diygary/FlightSimInstrumentPanel/README.md

Please visit https://www.diygary.com/instrumentpanel for more info.

NOTE: Not all dials/switches on the PCB are functional due to limitations with the SimConnect display (lack of writeable Simulation Variables)
