diygary/FlightSimInstrumentPanel/Schematics and Board Files/README.txt

Schematics and board files not shown here.
Contact Gary T Smith (aka DIYGary) for more info.
