diygary/FlightSimInstrumentPanel/schematic.brd

## EAGLE design schematic.brd (2021-06-20, last stored version)

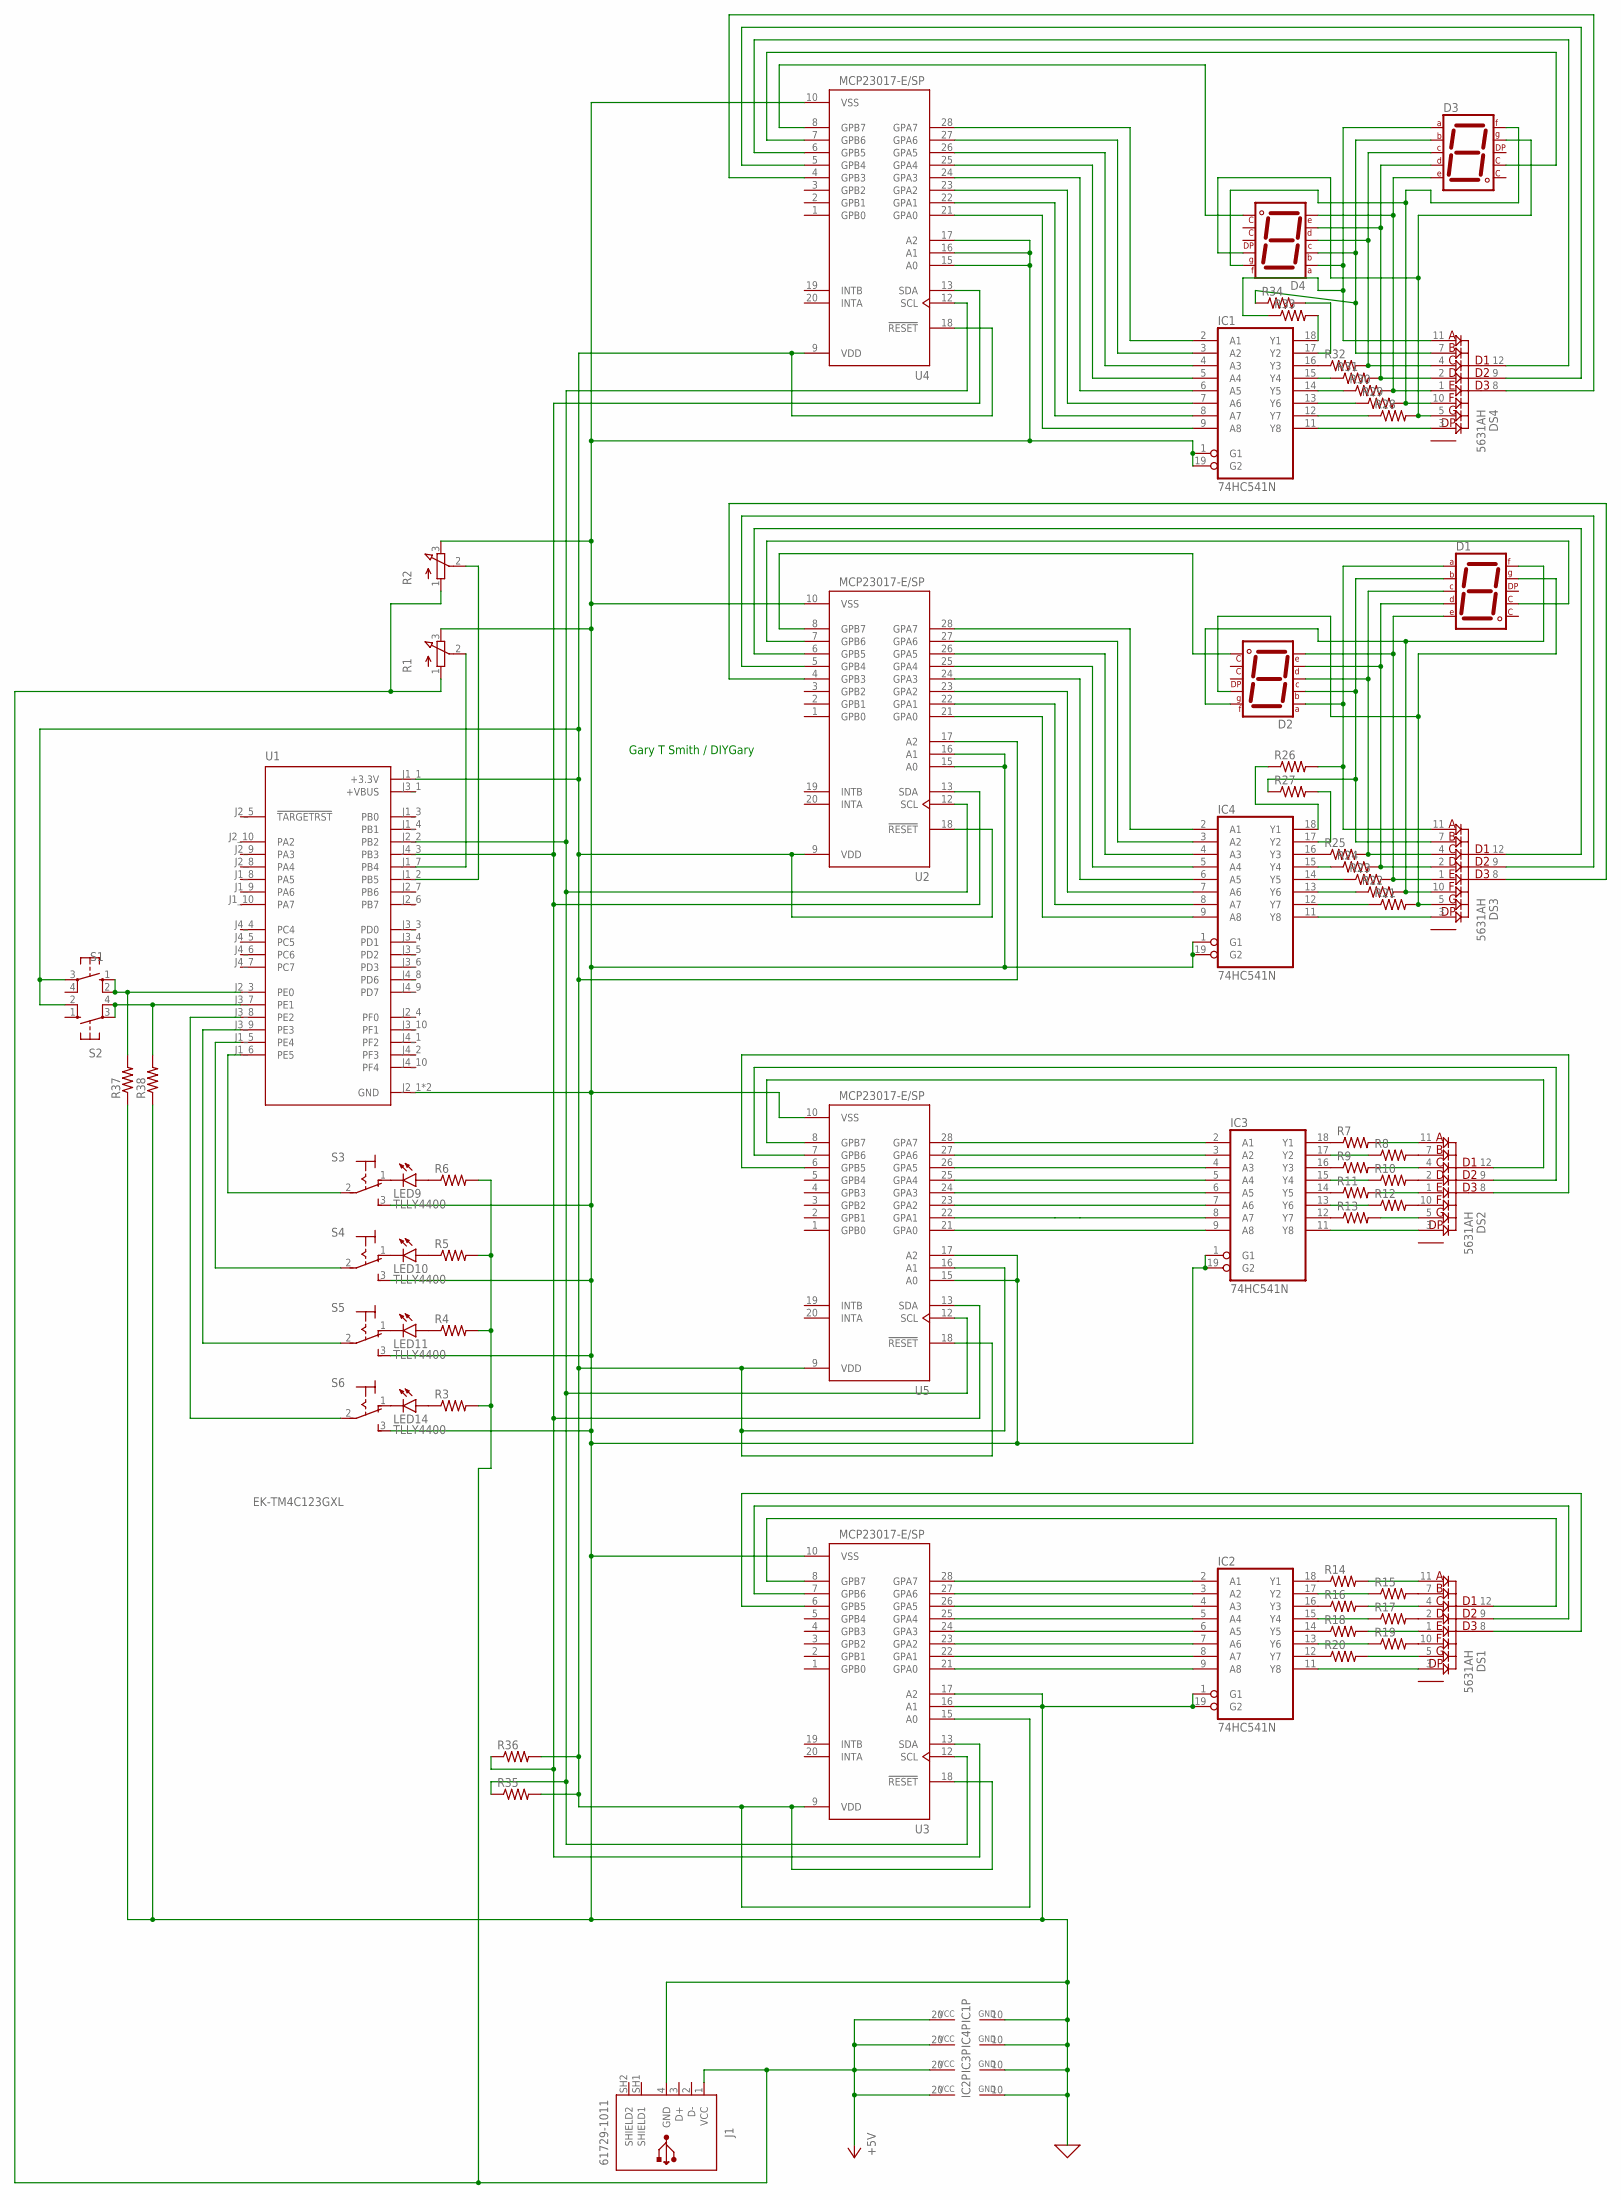
[picture p3: schematic schematic.sch]

Parts:
D1, D2, D3, D4: 5611AH
DS1, DS2, DS3, DS4: 5631AH; DIPS1524W50P254L3760H835Q12N
IC1, IC2, IC3, IC4: 74HC541N; DIL20
J1: 61729-1011; 61729-1011BLF
LED9, LED10, LED11, LED14: TLLY4400; LED3MM
R1, R2: 3RP/1610N
R3, R4, R5, R6, R7, R8, R9, R10, R11, R12, R13, R14, R15, R16, R17, R18, R19, R20, R21, R22, R23, R24, R25, R26, R27, R28, R29, R30, R31, R32, R33, R34, R35, R36, R37, R38: R-US_0204/7; 0204/7
S1, S2: 10-XX; B3F-10XX
S3, S4, S5, S6: 320-916
U1: EK-TM4C123GXL; MODULE_EK-TM4C123GXL
U2, U3, U4, U5: MCP23017-E/SP; DIP787W45P254L3556H508Q28

Connections:
0: IC1.1 (G1), IC1.10 (GND), IC1.19 (G2), IC2.1 (G1), IC2.10 (GND), IC2.19 (G2), IC3.1 (G1), IC3.10 (GND), IC3.19 (G2), IC4.1 (G1), IC4.10 (GND), IC4.19 (G2), J1.4 (GND), R1.3 (E), R2.3 (E), R37.1, R38.1, S3.3 (S), S4.3 (S), S5.3 (S), S6.3 (S), U1.J2_1 (GND), U1.J3_2 (GND), U2.10 (VSS), U2.15 (A0), U2.16 (A1), U3.10 (VSS), U3.16 (A1), U3.17 (A2), U4.10 (VSS), U4.15 (A0), U4.16 (A1), U4.17 (A2), U5.10 (VSS), U5.15 (A0), U5.17 (A2)
+VBUS: U1.J3_1 (+VBUS)
unnamed: IC1.9 (A8), U4.21 (GPA0)
unnamed: DS1.7 (A_B), R15.2
unnamed: DS1.2 (A_D), R17.2
unnamed: DS1.10 (A_F), R19.2
unnamed: DS2.7 (A_B), R8.2
unnamed: DS2.2 (A_D), R10.2
unnamed: DS2.10 (A_F), R12.2
unnamed: D3.7 (A), D4.7 (A), DS4.11 (A_A), R33.1
unnamed: IC1.8 (A7), U4.22 (GPA1)
unnamed: IC1.7 (A6), U4.23 (GPA2)
unnamed: IC1.6 (A5), U4.24 (GPA3)
unnamed: IC1.5 (A4), U4.25 (GPA4)
unnamed: IC1.4 (A3), U4.26 (GPA5)
unnamed: IC1.3 (A2), U4.27 (GPA6)
unnamed: IC1.2 (A1), U4.28 (GPA7)
unnamed: D3.3 (CK1), U4.7 (GPB6)
unnamed: DS4.12 (CC_D1), U4.6 (GPB5)
unnamed: DS4.9 (CC_D2), U4.5 (GPB4)
unnamed: DS4.8 (CC_D3), U4.4 (GPB3)
unnamed: D1.7 (A), D2.7 (A), DS3.11 (A_A), R26.2
unnamed: IC1.16 (Y3), R32.1
unnamed: IC1.12 (Y7), R28.1
unnamed: IC1.13 (Y6), R29.1
unnamed: D1.1 (E), D2.1 (E), DS3.1 (A_E), R23.2
unnamed: IC1.14 (Y5), R30.1
unnamed: IC1.15 (Y4), R31.1
unnamed: DS3.3 (A_DP), IC4.11 (Y8)
unnamed: DS4.3 (A_DP), IC1.11 (Y8)
unnamed: DS3.9 (CC_D2), U2.5 (GPB4)
unnamed: D1.3 (CK1), U2.7 (GPB6)
unnamed: DS3.12 (CC_D1), U2.6 (GPB5)
unnamed: DS3.8 (CC_D3), U2.4 (GPB3)
unnamed: IC4.9 (A8), U2.21 (GPA0)
unnamed: IC4.8 (A7), U2.22 (GPA1)
unnamed: IC4.7 (A6), U2.23 (GPA2)
unnamed: IC4.6 (A5), U2.24 (GPA3)
unnamed: IC4.5 (A4), U2.25 (GPA4)
unnamed: IC4.4 (A3), U2.26 (GPA5)
unnamed: IC4.3 (A2), U2.27 (GPA6)
unnamed: IC4.2 (A1), U2.28 (GPA7)
unnamed: IC3.18 (Y1), R7.1
unnamed: IC1.20 (VCC), IC2.20 (VCC), IC3.20 (VCC), IC4.20 (VCC), J1.1 (VCC), R1.1 (A), R2.1 (A), R3.2, R4.2, R5.2, R6.2
unnamed: IC3.16 (Y3), R9.1
unnamed: IC3.14 (Y5), R11.1
unnamed: IC3.12 (Y7), R13.1
unnamed: DS2.3 (A_DP), IC3.11 (Y8)
unnamed: DS2.12 (CC_D1), U5.8 (GPB7)
unnamed: DS2.9 (CC_D2), U5.7 (GPB6)
unnamed: DS2.8 (CC_D3), U5.6 (GPB5)
unnamed: IC3.2 (A1), U5.28 (GPA7)
unnamed: IC3.3 (A2), U5.27 (GPA6)
unnamed: IC3.4 (A3), U5.26 (GPA5)
unnamed: IC3.5 (A4), U5.25 (GPA4)
unnamed: IC3.6 (A5), U5.24 (GPA3)
unnamed: IC3.7 (A6), U5.23 (GPA2)
unnamed: IC3.8 (A7), U5.22 (GPA1)
unnamed: IC3.9 (A8), U5.21 (GPA0)
unnamed: IC2.2 (A1), U3.28 (GPA7)
unnamed: IC2.3 (A2), U3.27 (GPA6)
unnamed: IC2.4 (A3), U3.26 (GPA5)
unnamed: IC2.5 (A4), U3.25 (GPA4)
unnamed: IC2.6 (A5), U3.24 (GPA3)
unnamed: IC2.7 (A6), U3.23 (GPA2)
unnamed: IC2.8 (A7), U3.22 (GPA1)
unnamed: IC2.9 (A8), U3.21 (GPA0)
unnamed: IC2.18 (Y1), R14.1
unnamed: IC2.16 (Y3), R16.1
unnamed: IC2.14 (Y5), R18.1
unnamed: IC2.12 (Y7), R20.1
unnamed: DS1.3 (A_DP), IC2.11 (Y8)
unnamed: DS1.12 (CC_D1), U3.8 (GPB7)
unnamed: DS1.9 (CC_D2), U3.7 (GPB6)
unnamed: DS1.8 (CC_D3), U3.6 (GPB5)
unnamed: LED14.K (C), S6.1 (O)
unnamed: D2.8 (CK2), U2.8 (GPB7)
unnamed: DS1.5 (A_G), R20.2
unnamed: D4.8 (CK2), U4.8 (GPB7)
unnamed: LED10.K (C), S4.1 (O)
unnamed: S3.2, U1.J1_6 (PE5)
unnamed: S4.2, U1.J1_5 (PE4)
unnamed: S5.2, U1.J3_9 (PE3)
unnamed: S6.2, U1.J3_8 (PE2)
unnamed: LED14.A, R3.1
unnamed: LED11.K (C), S5.1 (O)
unnamed: LED11.A, R4.1
unnamed: LED9.K (C), S3.1 (O)
unnamed: LED10.A, R5.1
unnamed: LED9.A, R6.1
unnamed: R38.2, S2.3, S2.4 (P1), U1.J3_7 (PE1)
unnamed: R37.2, S1.1 (S), S1.2 (S1), U1.J2_3 (PE0)
unnamed: R1.2 (S), U1.J1_7 (PB4)
unnamed: R2.2 (S), U1.J1_2 (PB5)
unnamed: R35.1, U1.J2_2 (PB2), U2.12 (SCL), U3.12 (SCL), U4.12 (SCL), U5.12 (SCL)
unnamed: R36.1, U1.J4_3 (PB3), U2.13 (SDA), U3.13 (SDA), U4.13 (SDA), U5.13 (SDA)
unnamed: R35.2, R36.2, S1.3, S2.2 (S1), U1.J1_1 (+3.3V), U2.9 (VDD), U2.17 (A2), U2.18 (!RESET), U3.9 (VDD), U3.15 (A0), U3.18 (!RESET), U4.9 (VDD), U4.18 (!RESET), U5.9 (VDD), U5.16 (A1), U5.18 (!RESET)
unnamed: IC2.13 (Y6), R19.1
unnamed: DS1.1 (A_E), R18.2
unnamed: IC2.15 (Y4), R17.1
unnamed: DS1.4 (A_C), R16.2
unnamed: IC2.17 (Y2), R15.1
unnamed: DS1.11 (A_A), R14.2
unnamed: DS2.5 (A_G), R13.2
unnamed: IC3.13 (Y6), R12.1
unnamed: DS2.1 (A_E), R11.2
unnamed: IC3.15 (Y4), R10.1
unnamed: DS2.4 (A_C), R9.2
unnamed: IC3.17 (Y2), R8.1
unnamed: DS2.11 (A_A), R7.2
unnamed: IC1.18 (Y1), R33.2
unnamed: D1.6 (B), D2.6 (B), DS3.7 (A_B), R27.1
unnamed: D1.4 (C), D2.4 (C), DS3.4 (A_C), R25.2
unnamed: D1.2 (D), D2.2 (D), DS3.2 (A_D), R24.2
unnamed: D1.9 (F), D2.9 (F), DS3.10 (A_F), R22.2
unnamed: D1.10 (G), D2.10 (G), DS3.5 (A_G), R21.2
unnamed: IC1.17 (Y2), R34.2
unnamed: D3.6 (B), D4.6 (B), DS4.7 (A_B), R34.1
unnamed: D3.4 (C), D4.4 (C), DS4.4 (A_C), R32.2
unnamed: D3.2 (D), D4.2 (D), DS4.2 (A_D), R31.2
unnamed: D3.1 (E), D4.1 (E), DS4.1 (A_E), R30.2
unnamed: D3.9 (F), D4.9 (F), DS4.10 (A_F), R29.2
unnamed: D3.10 (G), D4.10 (G), DS4.5 (A_G), R28.2
unnamed: IC4.16 (Y3), R25.1
unnamed: IC4.15 (Y4), R24.1
unnamed: IC4.14 (Y5), R23.1
unnamed: IC4.13 (Y6), R22.1
unnamed: IC4.12 (Y7), R21.1
unnamed: IC4.18 (Y1), R26.1
unnamed: IC4.17 (Y2), R27.2

Notes on the sheet:
Gary T Smith / DIYGary

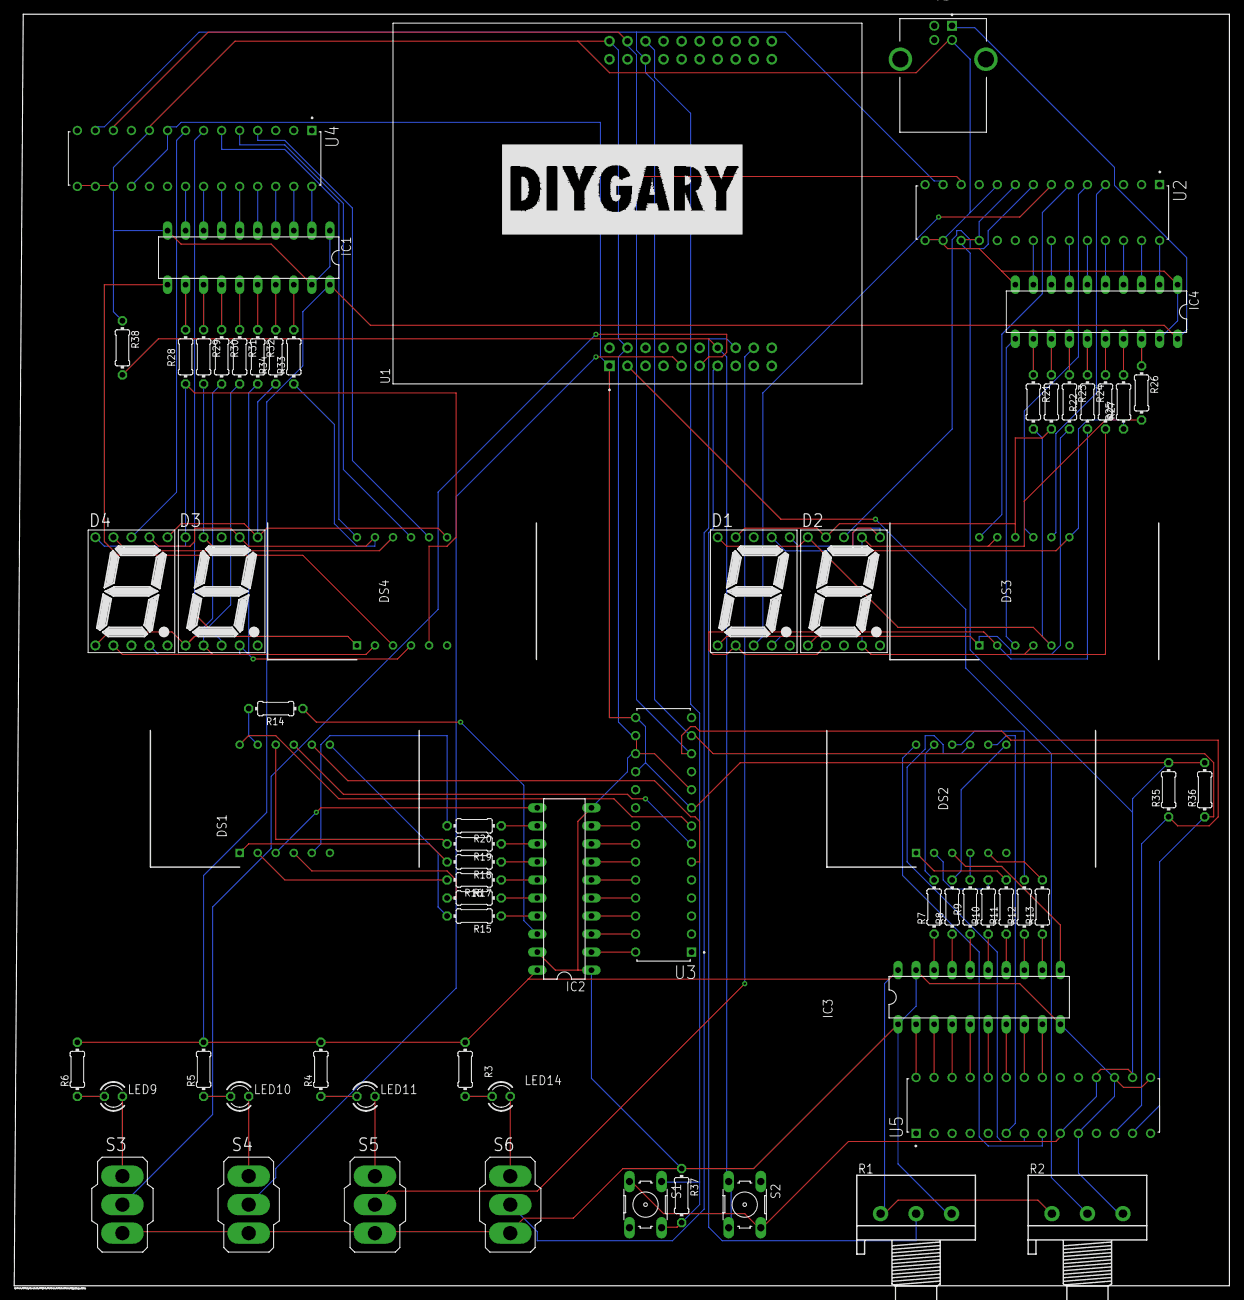
[picture p4: board schematic.brd from above]

Board: 2 copper layers, 171.1 x 179.1 mm, 66 parts (0 on the bottom side), 129 nets.
