diygary/FlightSimInstrumentPanel/(commit log)

2021-06-18 Schematic finished, board partially done
    [schematic.brd, schematic.sch]
2021-06-20 Final version
    [schematic.brd, schematic.sch]
2021-06-28 Port initializations finished, I2C init finished
2021-08-01 official schematic of board
    [schematic_v2.sch]
2021-08-02 schematics and board files not available
    [schematic.brd, schematic.sch, schematic_v2.sch]
